fkummer/GoodnightPi/Website/images/IMG_3987.JPG

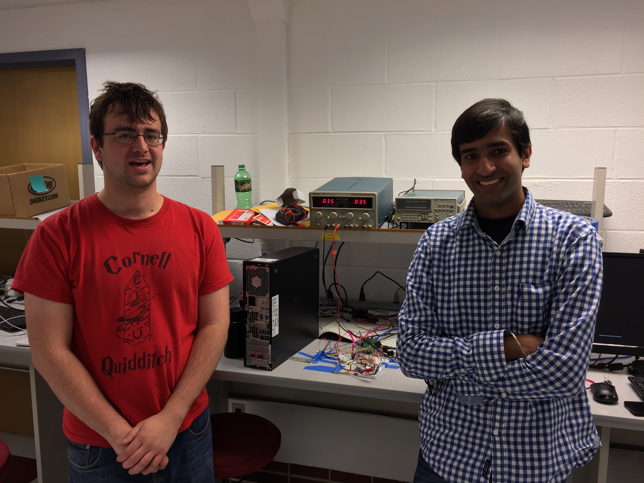
Website/images/IMG_3987.JPG
