fkummer/GoodnightPi/Website/images/IMG_3984.JPG

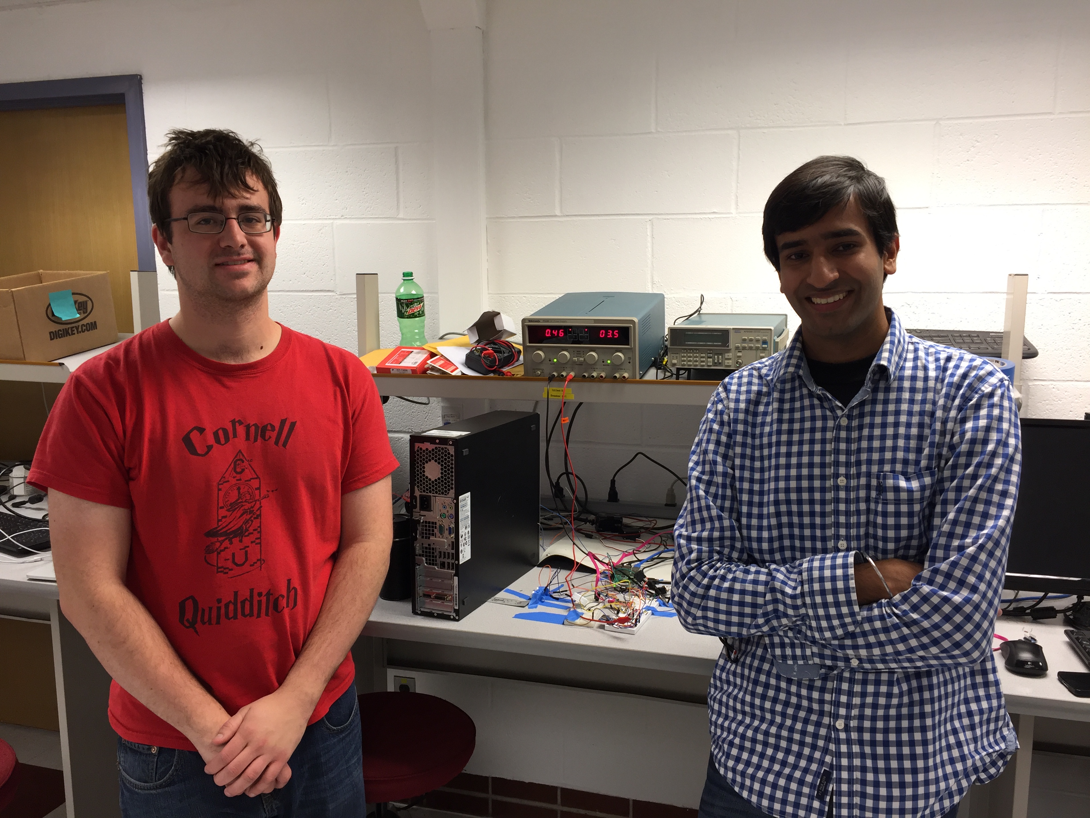
Website/images/IMG_3984.JPG
