fkummer/GoodnightPi/interrupt.jpg

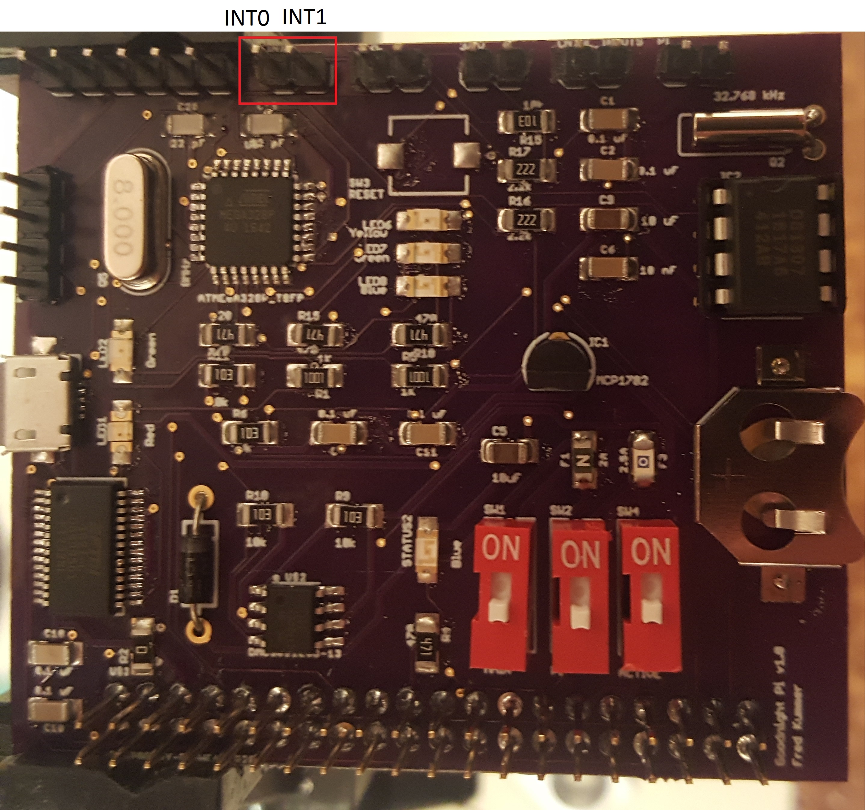
interrupt.jpg
