fkummer/GoodnightPi/LED.jpg

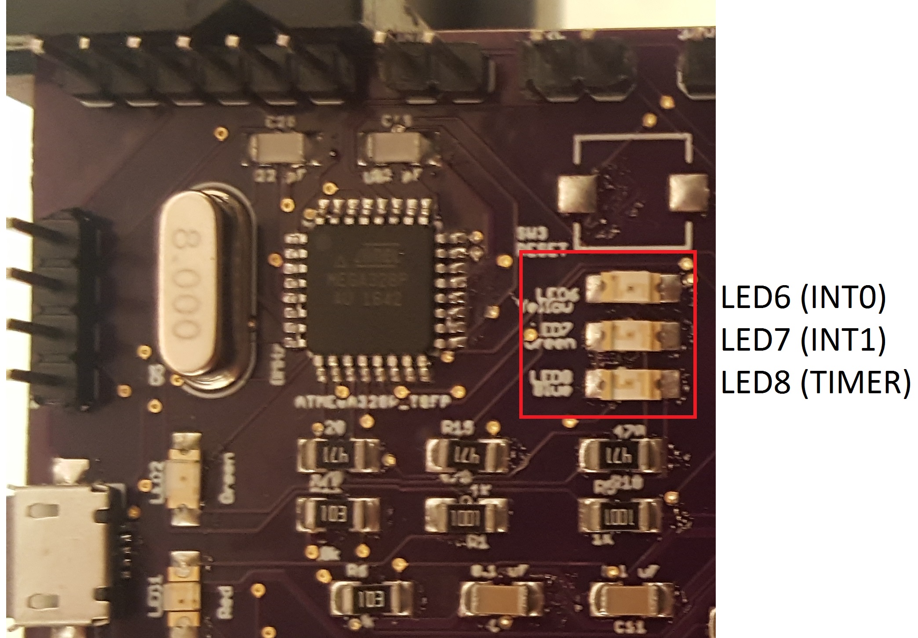
LED.jpg
