fkummer/GoodnightPi/switches.jpg

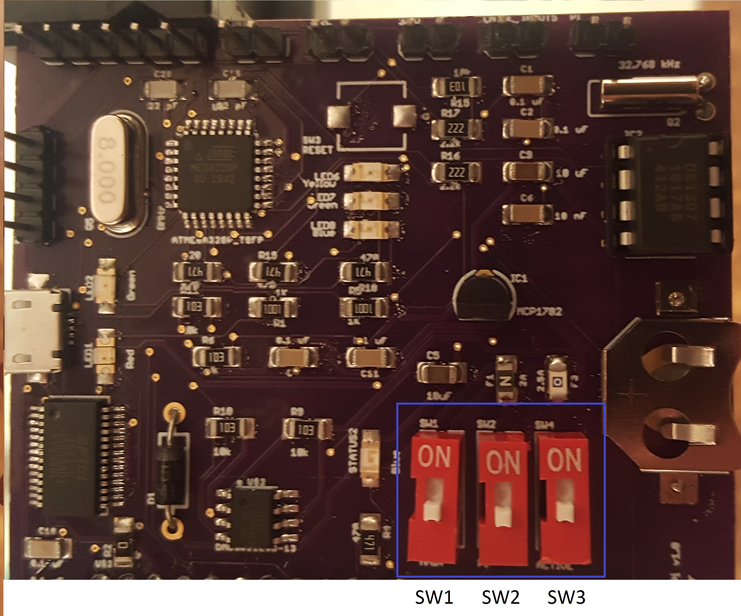
switches.jpg
