fkummer/GoodnightPi/Website/images/at_circ.jpg

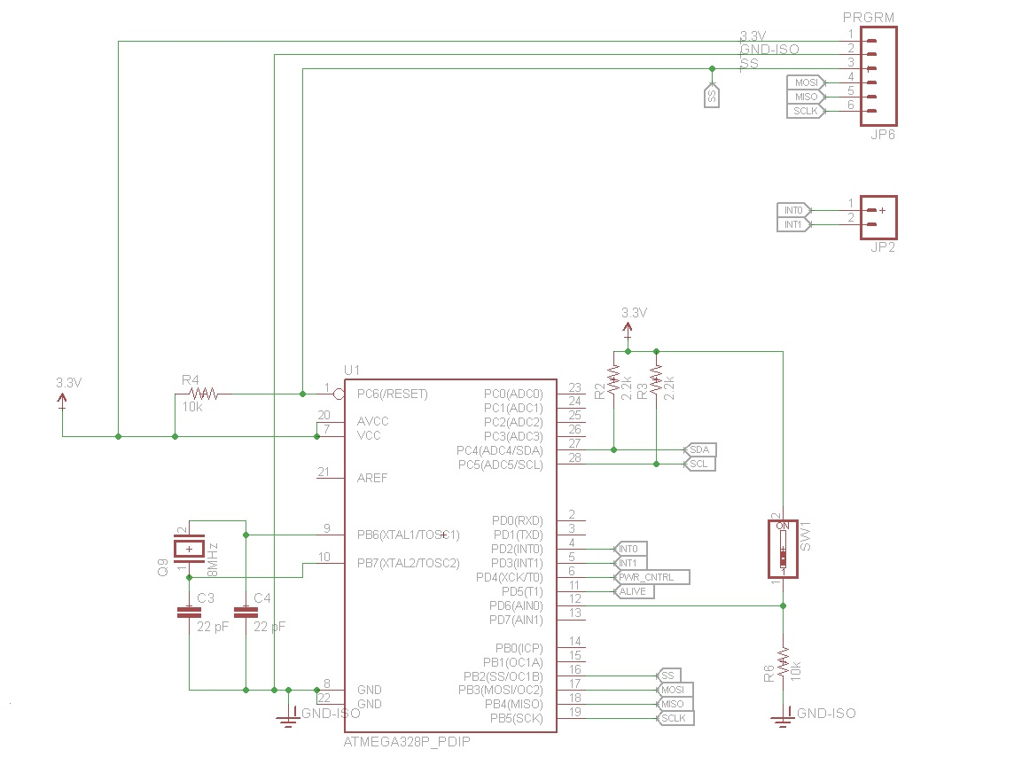
Website/images/at_circ.jpg
