fkummer/GoodnightPi/Website/images/at_spi.jpg

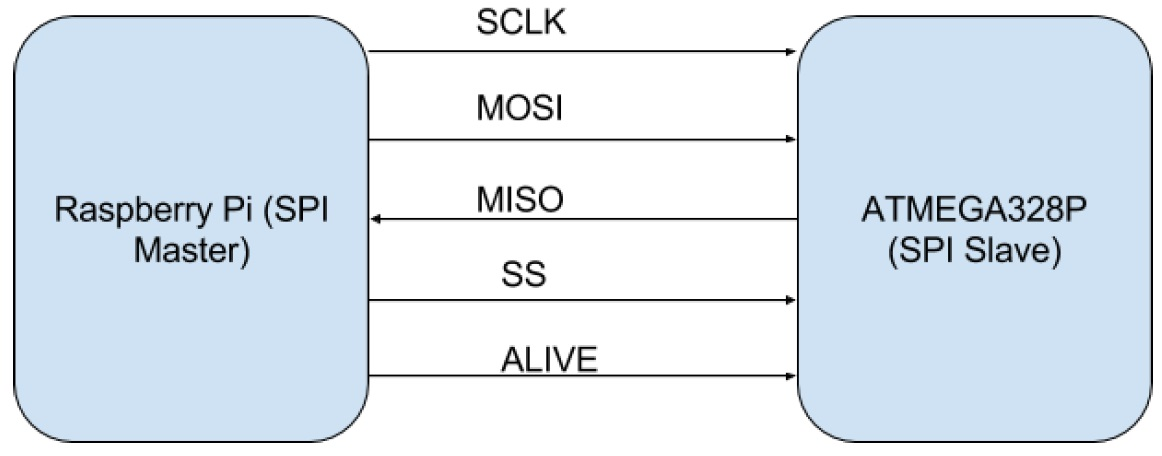
Website/images/at_spi.jpg
