fkummer/GoodnightPi/Website/images/atmega_cycle.jpg

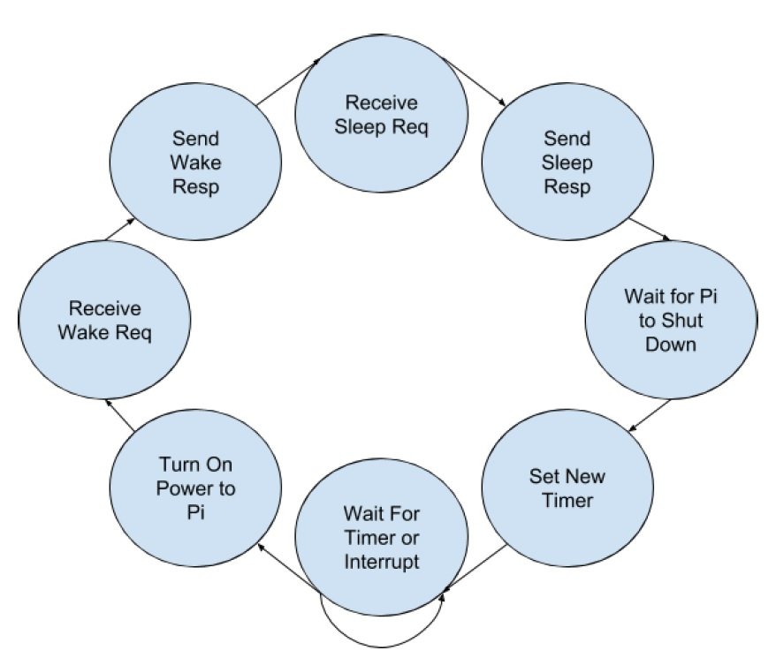
Website/images/atmega_cycle.jpg
