fkummer/GoodnightPi/Website/images/block.jpg

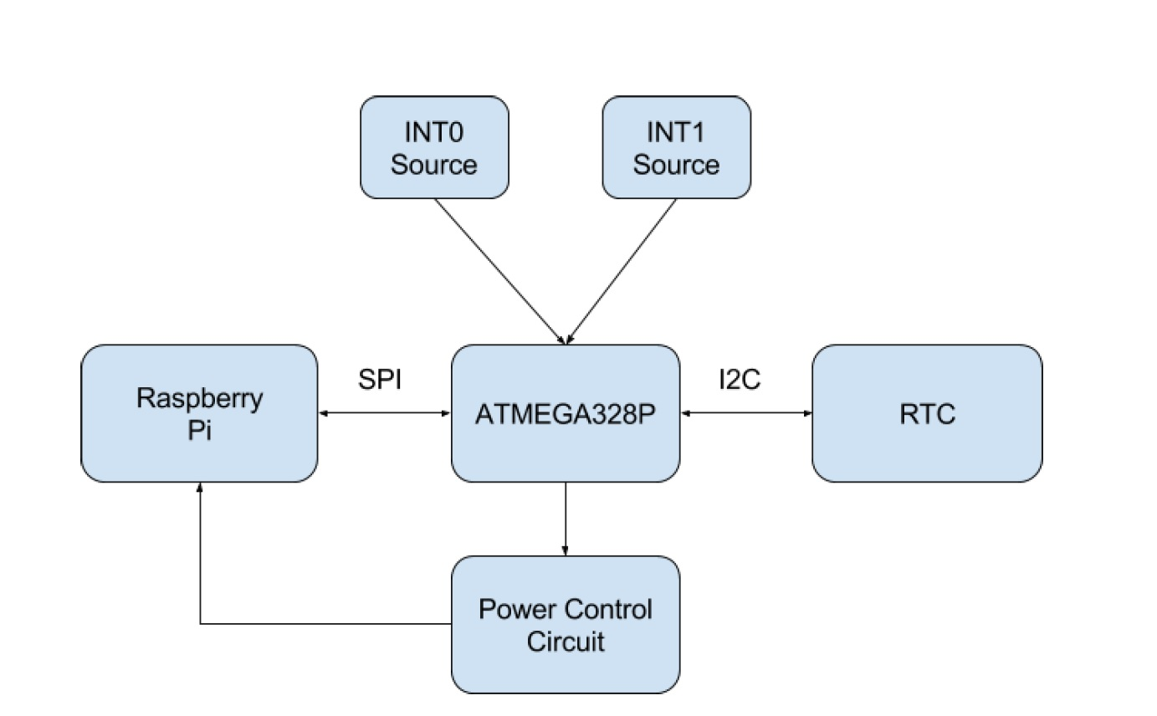
Website/images/block.jpg
