fkummer/GoodnightPi/Website/images/full_schem.jpg

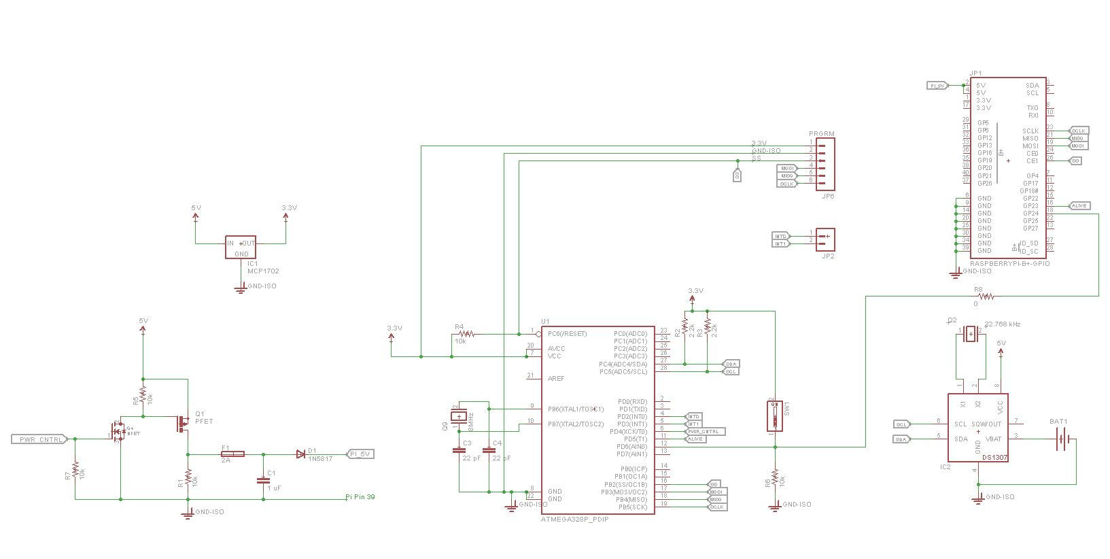
Website/images/full_schem.jpg
