fkummer/GoodnightPi/Website/images/GUI.PNG

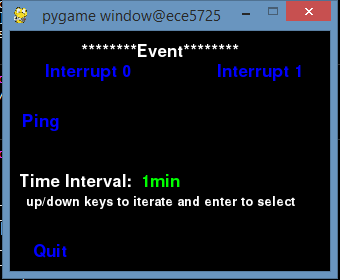
Website/images/GUI.PNG
