fkummer/GoodnightPi/Website/images/IMG_3982.JPG

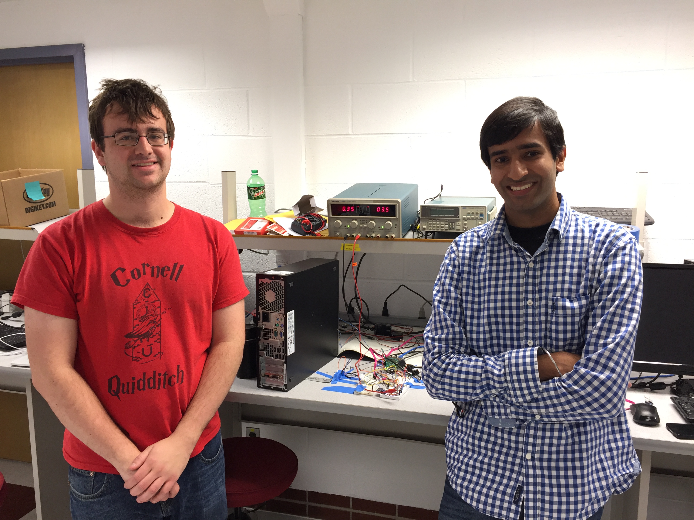
Website/images/IMG_3982.JPG
