fkummer/GoodnightPi/Website/images/IMG_3988.JPG

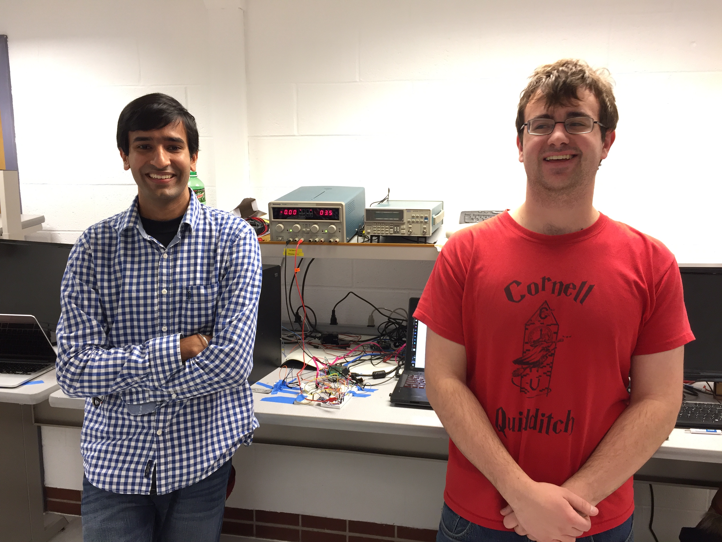
Website/images/IMG_3988.JPG
