fkummer/GoodnightPi/Website/images/pcu.jpg

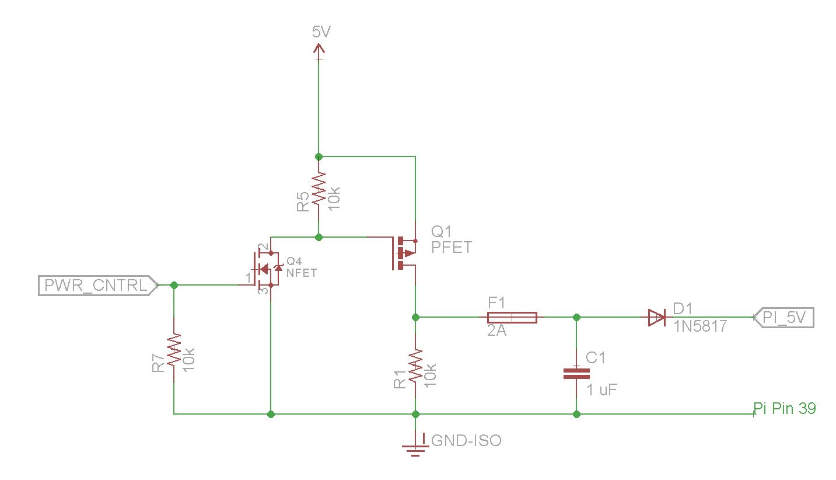
Website/images/pcu.jpg
