fkummer/GoodnightPi/Website/images/pi_cycle.jpg

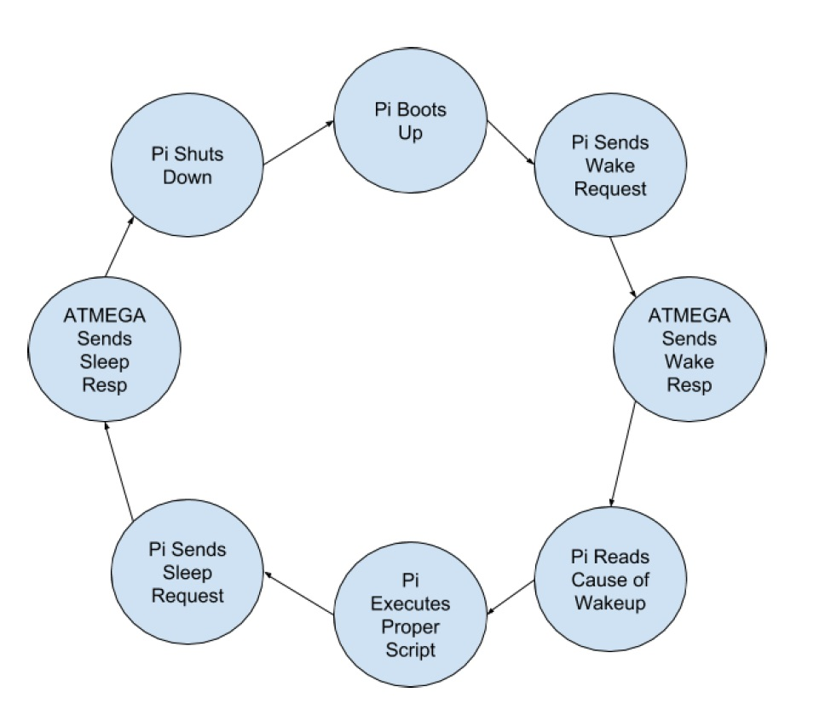
Website/images/pi_cycle.jpg
