fkummer/GoodnightPi/Website/images/rtc.jpg

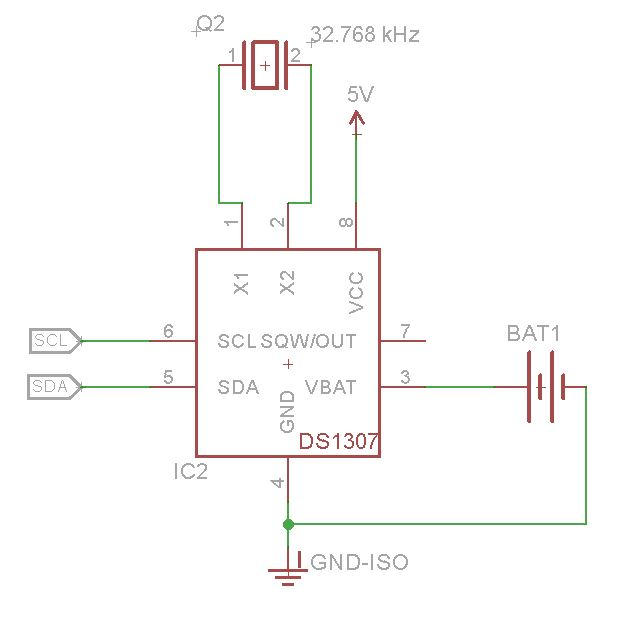
Website/images/rtc.jpg
