fkummer/GoodnightPi/Website/images/team.jpg

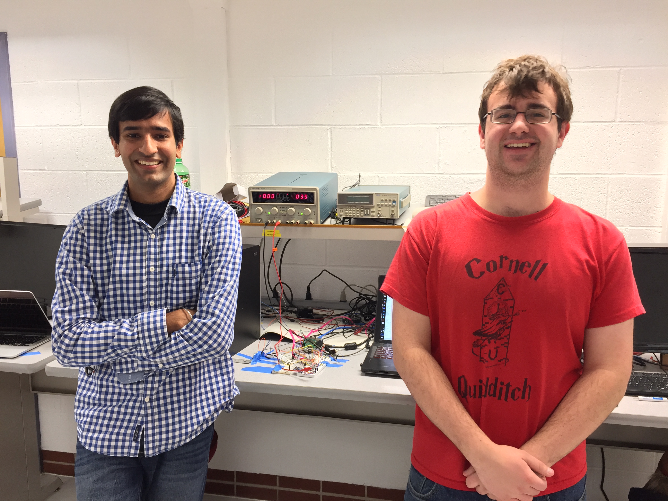
Website/images/team.jpg
