fkummer/GoodnightPi/PCU_R0.brd

## EAGLE design PCU_R0.brd (2017-05-02)

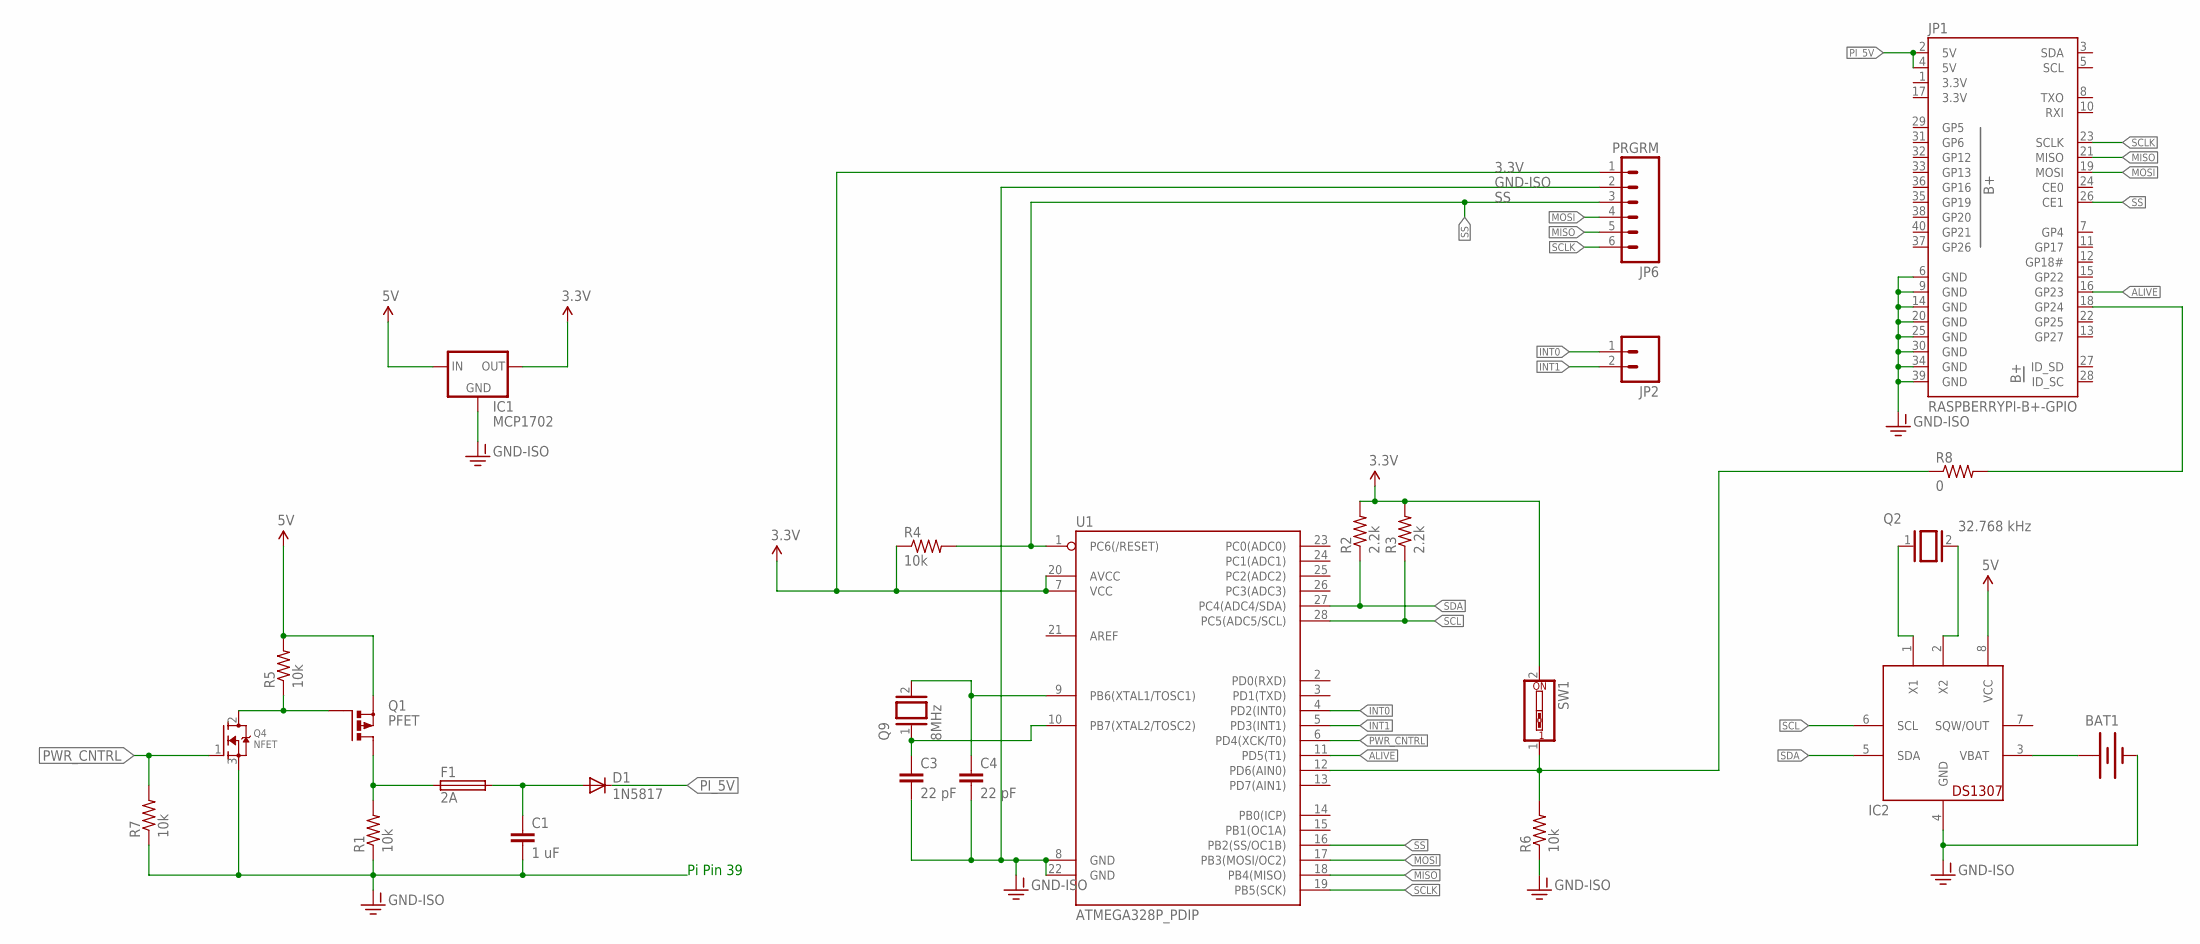
[picture p22: schematic PCU_R0.sch]

Parts:
BAT1: BATTERY12MM; BATTCON_12MM
C1: 1 uF; C2.5-3
C3, C4: 22 pF; C2.5-3
D1: 1N5817; DO41-10
F1: 2A; PICOFUSE
IC1: MCP1702; TO92
IC2: DS1307; DIL08
JP1: RASPBERRYPI-B+-GPIO; 2X20-SHROUDED
JP2: M02PTH; 1X02
JP6: PRGRM; 1X06
Q1: PFET; TO220BV
Q2: 32.768 kHz; QS
Q4: NFET; TO220V
Q9: 8MHz; QS
R1, R4, R5, R6, R7: 10k; 1206
R2, R3: 2.2k; 1206
R8: 0; 1206
SW1: SW_DIP-1; EDG-01
U1: ATMEGA328P_PDIP; DIL28-3

Connections:
3.3V: IC1.3 (OUT), JP1.1 (3.3V), JP1.17 (3.3V), JP6.1, R2.2, R3.2, R4.1, SW1.2, U1.7 (VCC), U1.20 (AVCC)
5V: IC1.2 (IN), IC2.8 (VCC), Q1.S, R5.2
ALIVE: JP1.16 (GP23), U1.11 (PD5(T1))
GND-ISO: BAT1.GND (-), C1.2, C3.2, C4.2, IC1.1 (GND), IC2.4 (GND), JP1.6 (GND), JP1.9 (GND), JP1.14 (GND), JP1.20 (GND), JP1.25 (GND), JP1.30 (GND), JP1.34 (GND), JP1.39 (GND), JP6.2, Q4.3 (S), R1.1, R6.1, R7.1, U1.8 (GND), U1.22 (GND)
INT0: JP2.1, U1.4 (PD2(INT0))
INT1: JP2.2, U1.5 (PD3(INT1))
MISO: JP1.21 (MISO), JP6.5, U1.18 (PB4(MISO))
MOSI: JP1.19 (MOSI), JP6.4, U1.17 (PB3(MOSI/OC2))
unnamed: F1.1, Q1.D, R1.2
unnamed: C1.1, D1.A, F1.2
unnamed: IC2.1 (X1), Q2.1
unnamed: IC2.2 (X2), Q2.2
unnamed: BAT1.PWR@1 (+), IC2.3 (VBAT)
unnamed: Q1.G, Q4.2 (D), R5.1
unnamed: JP1.18 (GP24), R8.2
unnamed: R6.2, R8.1, SW1.1, U1.12 (PD6(AIN0))
unnamed: C3.1, Q9.1, U1.10 (PB7(XTAL2/TOSC2))
unnamed: C4.1, Q9.2, U1.9 (PB6(XTAL1/TOSC1))
PI_5V: D1.C, JP1.2 (5V), JP1.4 (5V)
PWR_CNTRL: Q4.1 (G), R7.2, U1.6 (PD4(XCK/T0))
SCL: IC2.6 (SCL), R3.1, U1.28 (PC5(ADC5/SCL))
SCLK: JP1.23 (SCLK), JP6.6, U1.19 (PB5(SCK))
SDA: IC2.5 (SDA), R2.1, U1.27 (PC4(ADC4/SDA))
SS: JP1.26 (CE1), JP6.3, R4.2, U1.1 (PC6(/RESET)), U1.16 (PB2(SS/OC1B))

Notes on the sheet:
Pi Pin 39

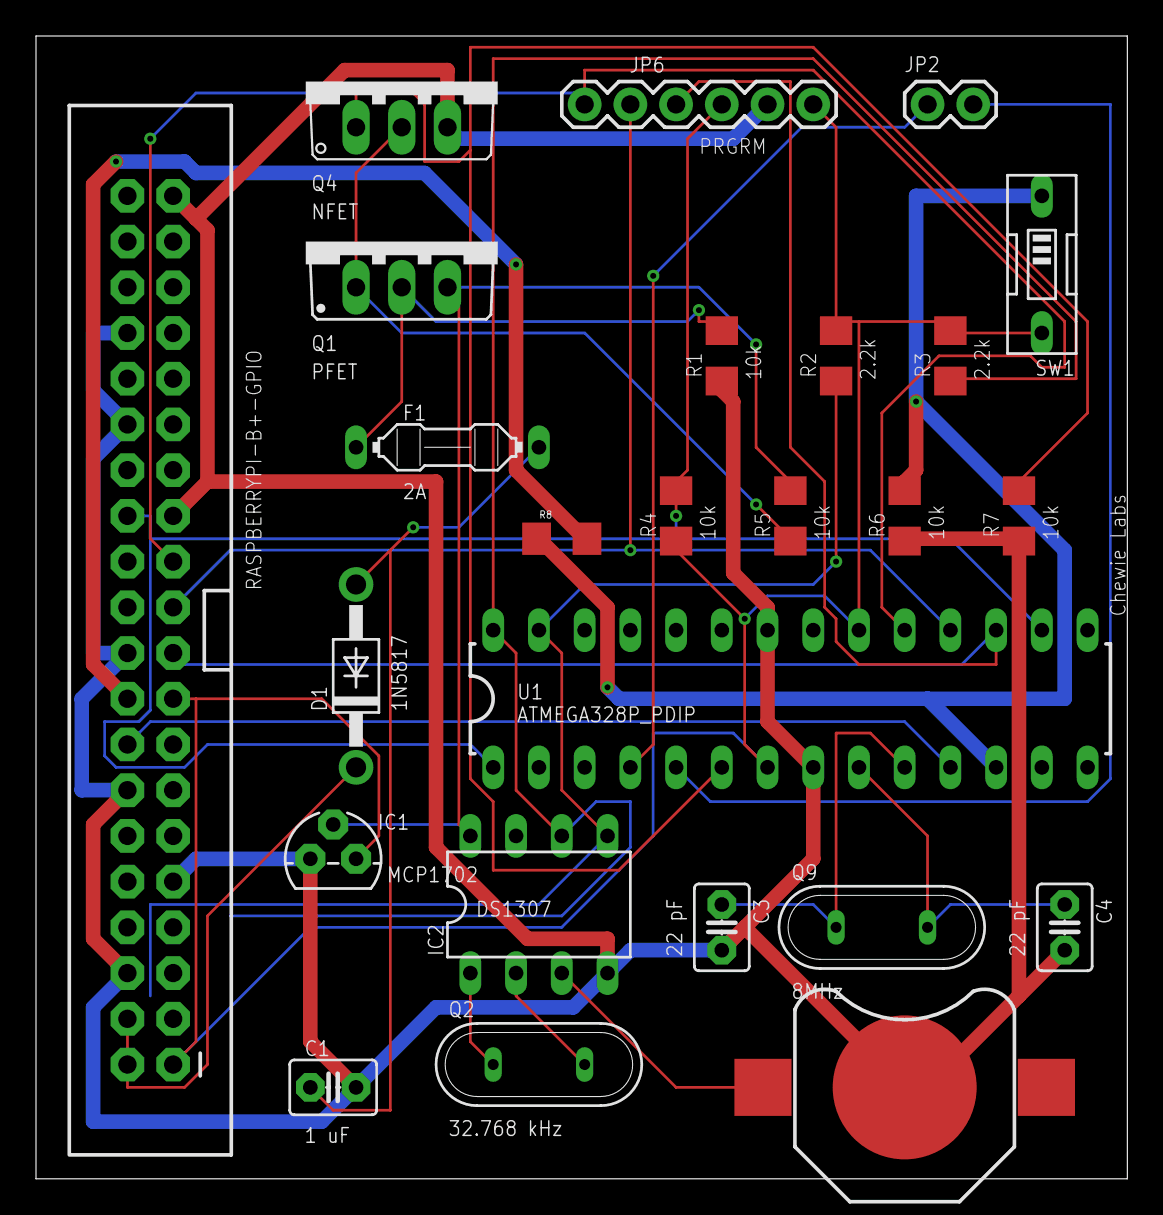
[picture p23: board PCU_R0.brd from above]

Board: 2 copper layers, 60.6 x 63.5 mm, 25 parts (0 on the bottom side), 24 nets.
