fkummer/GoodnightPi/PCU_R1.brd

## EAGLE design PCU_R1.brd (2017-05-02)

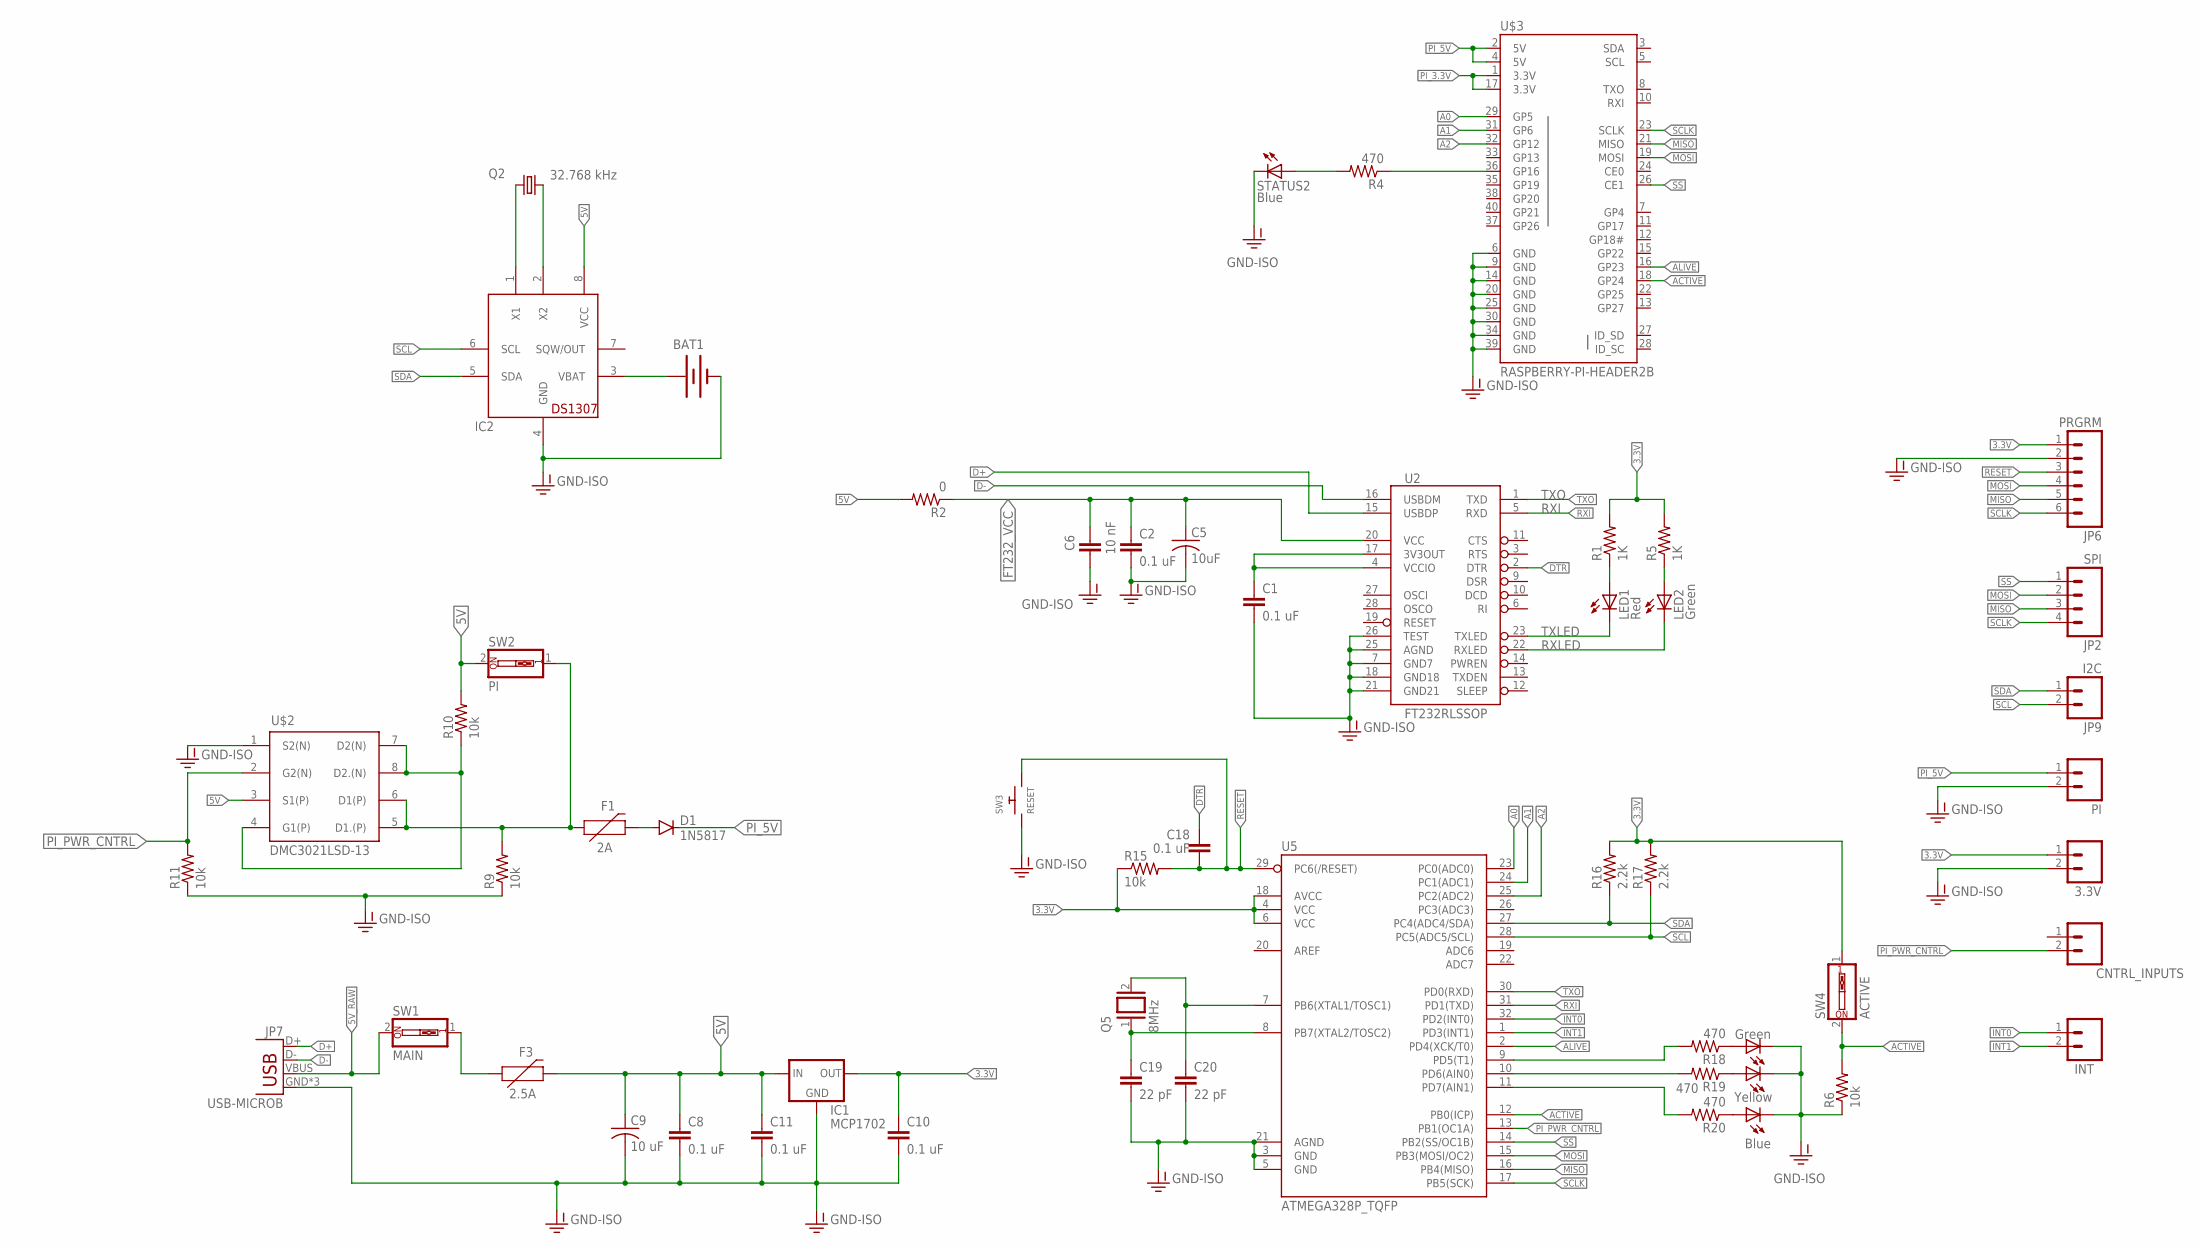
[picture p24: schematic PCU_R1.sch]

Parts:
3.3V: M02PTH; 1X02
BAT1: BATTERY12MM; BATTCON_12MM
C1, C2, C8, C10, C11, C18: 0.1 uF; 1206
C5: 10uF; C1206
C6: 10 nF; 1206
C9: 10 uF; C1206
C19, C20: 22 pF; 1206
CNTRL_INPUTS: M02PTH; 1X02
D1: 1N5817; DIODE-1N4001
F1: 2A; 1206
F3: 2.5A; 1206
IC1: MCP1702; TO92
IC2: DS1307; DIL08
INT: M02PTH; 1X02
JP2: SPI; 1X04
JP6: PRGRM; 1X06
JP7: USB-MICROB
JP9: I2C; 1X02
LED1: Red; CHIPLED_1206
LED2, LED6: Green; CHIPLED_1206
LED7: Yellow; CHIPLED_1206
LED8: Blue; CHIPLED_1206
PI: M02PTH; 1X02
Q2: 32.768 kHz; TC38H
Q5: 8MHz; QS
R1, R5: 1K; 1206
R2: 0; 1206
R4, R18, R19, R20: 470; 1206
R6, R15: 10k; 1206
R9, R10, R11: 10k; R1206
R16, R17: 2.2k; 1206
STATUS2: Blue; CHIPLED_1206
SW1: MAIN; EDG-01
SW2: PI; EDG-01
SW3: RESET; PUSHBUTTON_SMD_SJ
SW4: ACTIVE; EDG-01
U2: FT232RLSSOP; SSOP28DB
U5: ATMEGA328P_TQFP; TQFP32-08
U$2: DMC3021LSD-13; SOIC-8
U$3: RASPBERRY-PI-HEADER2B; 2X20-NOSILK

Connections:
3.3V: 3.3V.1, C10.1, IC1.3 (OUT), JP6.1, R1.2, R5.2, R15.1, R16.2, R17.2, SW4.1, U5.4 (VCC), U5.6 (VCC), U5.18 (AVCC)
5V: C8.1, C9.1, C11.1, F3.2, IC1.2 (IN), IC2.8 (VCC), R2.2, R10.2, SW2.2, U$2.3 (S1(P))
5V_RAW: JP7.VBUS, SW1.2
5V_SWITCH: F3.1, SW1.1
A0: U5.23 (PC0(ADC0)), U$3.29 (GP5)
A1: U5.24 (PC1(ADC1)), U$3.31 (GP6)
A2: U5.25 (PC2(ADC2)), U$3.32 (GP12)
ACTIVE: R6.2, SW4.2, U5.12 (PB0(ICP)), U$3.18 (GP24)
ALIVE: U5.2 (PD4(XCK/T0)), U$3.16 (GP23)
D+: JP7.D+, U2.15 (USBDP)
D-: JP7.D-, U2.16 (USBDM)
DTR: C18.1, U2.2 (DTR)
FT232_VCC: C2.1, C5.1, C6.2, R2.1, U2.20 (VCC)
FUSE_DIODE_PI: D1.A, F1.2
GND-ISO: 3.3V.2, BAT1.GND (-), C1.2, C2.2, C5.2, C6.1, C8.2, C9.2, C10.2, C11.2, C19.2, C20.2, IC1.1 (GND), IC2.4 (GND), JP6.2, JP7.GND, JP7.MT1 (GND), JP7.MT2 (GND), LED6.C, LED7.C, LED8.C, PI.2, R6.1, R9.1, R11.1, STATUS2.C, SW3.P$1, U2.7 (GND7), U2.18 (GND18), U2.21 (GND21), U2.25 (AGND), U2.26 (TEST), U5.3 (GND), U5.5 (GND), U5.21 (AGND), U$2.1 (S2(N)), U$3.6 (GND), U$3.9 (GND), U$3.14 (GND), U$3.20 (GND), U$3.25 (GND), U$3.30 (GND), U$3.34 (GND), U$3.39 (GND)
GP16: R4.1, U$3.36 (GP16)
INT0: INT.1, U5.32 (PD2(INT0))
INT1: INT.2, U5.1 (PD3(INT1))
MISO: JP2.3, JP6.5, U5.16 (PB4(MISO)), U$3.21 (MISO)
MOSI: JP2.2, JP6.4, U5.15 (PB3(MOSI/OC2)), U$3.19 (MOSI)
unnamed: LED1.A, R1.1
unnamed: LED2.A, R5.1
unnamed: IC2.1 (X1), Q2.1
unnamed: IC2.2 (X2), Q2.2
unnamed: BAT1.PWR@1 (+), IC2.3 (VBAT)
unnamed: R4.2, STATUS2.A
unnamed: LED6.A, R18.1
unnamed: LED7.A, R19.1
unnamed: LED8.A, R20.1
PD5: R18.2, U5.9 (PD5(T1))
PD6: R19.2, U5.10 (PD6(AIN0))
PD7: R20.2, U5.11 (PD7(AIN1))
PI_3.3V: U$3.1 (3.3V), U$3.17 (3.3V)
PI_5V: D1.C, PI.1, U$3.2 (5V), U$3.4 (5V)
PI_N_DRAIN: R10.1, U$2.4 (G1(P)), U$2.7 (D2(N)), U$2.8 (D2.(N))
PI_PWR_CNTRL: CNTRL_INPUTS.2, R11.2, U5.13 (PB1(OC1A)), U$2.2 (G2(N))
PI_P_DRAIN: F1.1, R9.2, SW2.1, U$2.5 (D1.(P)), U$2.6 (D1(P))
RESET: C18.2, JP6.3, R15.2, SW3.P$2, U5.29 (PC6(/RESET))
RXI: U2.5 (RXD), U5.31 (PD1(TXD))
RXLED: LED2.C, U2.22 (RXLED)
SCL: IC2.6 (SCL), JP9.2, R17.1, U5.28 (PC5(ADC5/SCL))
SCLK: JP2.4, JP6.6, U5.17 (PB5(SCK)), U$3.23 (SCLK)
SDA: IC2.5 (SDA), JP9.1, R16.1, U5.27 (PC4(ADC4/SDA))
SS: JP2.1, U5.14 (PB2(SS/OC1B)), U$3.26 (CE1)
TXLED: LED1.C, U2.23 (TXLED)
TXO: U2.1 (TXD), U5.30 (PD0(RXD))
VCCIO: C1.1, U2.4 (VCCIO), U2.17 (3V3OUT)
XTAL1: C20.1, Q5.2, U5.7 (PB6(XTAL1/TOSC1))
XTAL2: C19.1, Q5.1, U5.8 (PB7(XTAL2/TOSC2))

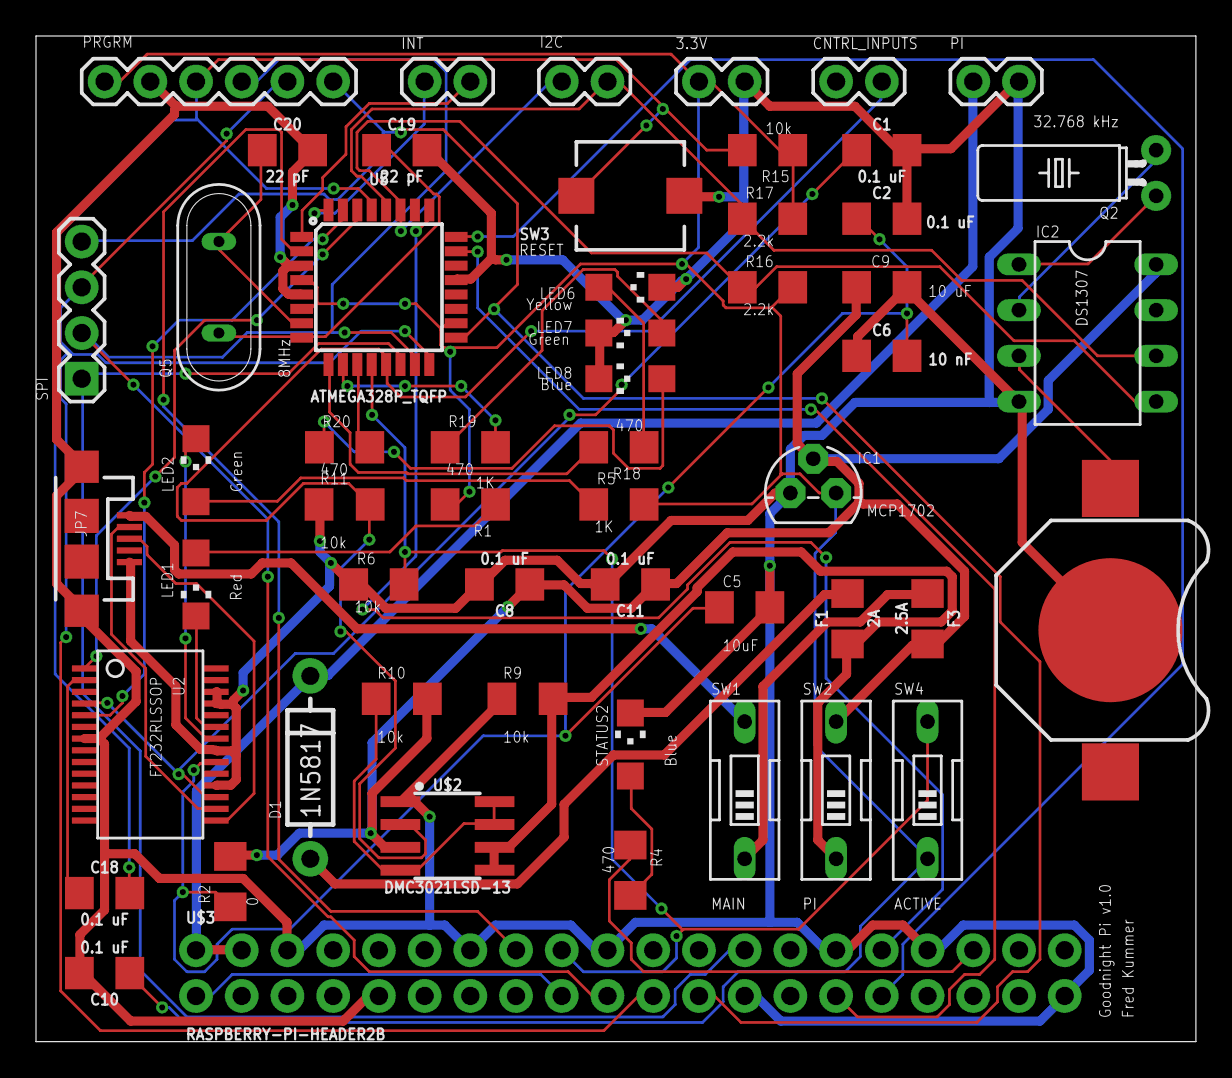
[picture p25: board PCU_R1.brd from above]

Board: 2 copper layers, 64.4 x 55.9 mm, 55 parts (0 on the bottom side), 49 nets.
