fkummer/GoodnightPi/ATMEGA_CODE/Full_Final/Full_Final.ino

#include "Wire.h"
#include <RTClib.h>
#include <SPI.h>
#include <EEPROM.h>

#define NOT_AN_INTERRUPT -1

//Variables for I2C
RTC_DS1307 rtc;
long wakeTime;
char timeSet = 0;
char ledState = 0;

//Variables for SPI
volatile unsigned char SPI_buff[100];
volatile byte cnt = 0;
volatile byte pos = 0;
volatile byte resp = 0;
volatile byte incoming = 0;
volatile byte outgoing = 0;
unsigned char resp_buff[11];
volatile unsigned char recv_packet[11];
volatile byte resp_ind = 0;
volatile byte supress_int = 0;

//Is Pi alive
boolean alive = 1;

//Do we want to turn off the power when we get the chance?
boolean gotoSleep = 0;

//timeInterval for our next wakeup.
long timeInterval = 0;

//Is int0 enabled
byte int0 = 0;

//Is int1 enable
byte int1 = 0;

//timer wants us to get up
byte timer_woke = 0;

//interrupt 0 wants us to get up
volatile byte int0_woke = 0;

//interrupt 1 wants us to get up
volatile byte int1_woke = 0;

//Are we waiting to get up
byte wait_for_wake = 0;

#define LED   7
#define PACKET_LEN 11
#define ALIVE 4
#define PWR_CNTRL 9
#define INT0 2
#define INT1 3
#define GREEN 6
#define YELLOW 5

// SPI interrupt routine
//Capture what is coming in. 
ISR (SPI_STC_vect)
{
  if(pos > 99){
    pos = 0;
  }
  
  //Serial.println(SPDR);
  
  //If we are receiving a packet
  if(incoming){
    cnt++;
    //Serial.println(SPDR);
    SPI_buff[pos] = SPDR;
    pos++;
    
    if(cnt >= PACKET_LEN){
      Serial.println("itsa me");
      incoming = 0;
      outgoing = 1;
    }
  }else{//Look for start byte
    if(SPDR == 0xFE){
      //Serial.println("start");
      incoming = 1;
      
      outgoing = 0;
      cnt = 0;
    }
  }
  
  
  //The master is asking us for a response and we expect to return one.
  
  //HERES THE PROBLEM: We are overwriting the SPDR so we can't get this 0xFF? Or is this pi sending us Y? Check on scope.
  if(SPDR == 0xFF){
    //Serial.println("AH");
    SPDR = resp_buff[resp_ind];
    resp_ind++;
  }
  
}// end of interrupt service routine (ISR) SPI_STC_vect

byte getOpCode(byte receivedOpCode){
  switch (receivedOpCode){
    case 0x00://Respond to WAKE_REQ with WAKE_RESP
      return 0x01;
      break;
    case 0x02:
      return 0x03;
      break;
    case 0x04:
      return 0x05;
      break;
    case 0x06:
      return 0x07;
      break;
    default: 
      return 0xFF;
      break;
  }
}  

void fillPayload(byte opCode, unsigned char * buff){
  switch (opCode){
    case 0x01: //WAKE_RESP
      //4 bytes for the time interval that woke it
      if(timer_woke == 1){
        Serial.println("Timer woke");
        buff[1] = timeInterval & 0x000000FF;
        buff[2] = timeInterval & 0x0000FF00;
        buff[3] = timeInterval & 0x00FF0000;
        buff[4] = timeInterval & 0xFF000000;
      }else{
        buff[1] = 0;
        buff[2] = 0;
        buff[3] = 0;
        buff[4] = 0;
      }
      
      //1 byte for if interrupt 0 woke it or not
      if(int0_woke == 1){
        Serial.println("Interrupt 0 woke");
        buff[5] = 1;
      }else{
        buff[5] = 0;
      }
      
      //1 byte for if interrupt 1 woke it or not
      if(int1_woke == 1){
        Serial.println("Interrupt 1 woke");
        buff[6] = 1;
      }else{
        buff[6] = 0;
      }
      
      //4 empty bytes
      buff[7] = 0;
      buff[8] = 0;
      buff[9] = 0;
      buff[10] = 0x00;
      
      //Clear what woke us
      timer_woke = 0;
      int0_woke = 0;
      int1_woke = 0;
      break;
      
    case 0x03: //SLEEP_RESP
      fillEmpty(buff);
      break;
      
    case 0x05: //CONFIG_RESP
      fillEmpty(buff);
      break; 
    
    case 0x07: //PING_RESP
      fillEmpty(buff);
      break;
    
    default:
      fillEmpty(buff);
      break;
  }
 
} 

//Set things as needed.
void processPacket(volatile unsigned char * buff){
  unsigned char opCode = buff[0];
  Serial.println("process");
  Serial.println(opCode);
  switch(opCode){
    case 0x00://WAKE_REQ
      //We dont need to do anything!
      break;
      
    case 0x02://SLEEP_REQ
      //Time to sleep
      Serial.println("Im Sleepy");
      
      //Only sleep if we're configured to do something!
      if(timeInterval != 0x00000000 || int0 == 1 || int1 == 1){  
        Serial.println("I think I'll sleep");
        gotoSleep = 1;
      }
      break;
      
    case 0x04:
      int i;
      //Assemble the time interval!
      //Fetchez la vache!
      long tempInterval;
      tempInterval = 0x00000000;
      for(i = 4; i > 0; i--){
        tempInterval = tempInterval | buff[i];
        
        if(i > 1){
          tempInterval = tempInterval << 8;
        }
      }
      
      //This packet is not attempting to configure the timer
      if(tempInterval == 0x00000000){
        //Don't change the timeInterval
      }else{
        //Set interval
        timeInterval = tempInterval;

        //Save interval
        for(i = 4; i > 0; i--){
          EEPROM.write(1+i, buff[i]);
        }
      }
      
      Serial.println("Configured");
      Serial.println(timeInterval);
      
      //into enable/disable
      if(buff[5] == 1){
        Serial.println("\n\ntoggle int0");
        Serial.print("INT0:");
        int0 ^= 1;
        EEPROM.write(0, int0);
        Serial.println(int0);
        Serial.println("\n\n");
        
      }
      
      //int1 enable/disable
      if(buff[7] == 1){
        Serial.println("toggle int1");
        int1 ^= 1;
        EEPROM.write(1, int1);
      }
      
      break;
      
    case 0x06:
      //We dont need to do anything!
      break;
      
    default:
      break;
  }
  
}

void processInterrupts(){

  
}

//Specifically for populating empty payloads, since its so common.
void fillEmpty(unsigned char * buff){
  byte buff_ind;
  for(buff_ind = 1; buff_ind < PACKET_LEN; buff_ind++){
    buff[buff_ind] = 'a';
  }
}

//Pass in the number of seconds until next wake up, calculate 
//the appropriate unix time for to wake up. Set the timer flag
void setWakeupTime(long seconds){
  Serial.println("Set");
  wakeTime = rtc.now().unixtime() + seconds;
  timeSet = 1;
}

char checkWakeup(){
  //Serial.println(timeSet, DEC);
  if(timeSet != 0){
    //Serial.println(rtc.now().unixtime());
    //delay(1000);
    if(rtc.now().unixtime() >= wakeTime){
      //Time to get up!
     timeSet = 0;
     timer_woke = 1;
     Serial.println("hm");
     return 1;  
    }
  }

  return 0;
}

void handleSPI(){
  //Received a full packet, lets print it
  //We should also get our response ready!
  
  if(cnt == PACKET_LEN){  
    //Print out the packet
    byte ind;
    
    if(pos < PACKET_LEN){
      ind = 99-(pos+1);
    }else{
      ind = (pos-PACKET_LEN)%100;
    }
    
    for(int i = 0; i < PACKET_LEN; i++){
      if(ind > 99){
        ind = 0;
      }
      recv_packet[i] = SPI_buff[ind];
      ind++;
    }
    cnt = 0;

    if(outgoing){
      Serial.println("wow");
      processPacket(recv_packet);
      resp_buff[0] = getOpCode(recv_packet[0]);
      fillPayload(resp_buff[0], resp_buff); 
      SPDR = resp_buff[0];
      resp_ind = 1;
      outgoing = 0;
    }
  }
}

void turnOffPower(){
  Serial.println("going down");
  gotoSleep = 0;
  digitalWrite(PWR_CNTRL, LOW);
  return;
}

void int0_handler(){
  //If interrupts are allowed to wake us
  Serial.println("whoa cool");
  if(int0 == 1){
    Serial.println("neat");
    int int0_cnt = 0;
    while(digitalRead(INT0) && (int0_cnt < 500)){
      int0_cnt = int0_cnt + 1;
    }
    
    if(int0_cnt >= 500){
      Serial.println("awesome");
      int0_woke = 1;
      timeSet = 0;
    }
  }else{
    int0_woke = 0;
  }
}

void int1_handler(){
  //If interrupts are allowed to wake us
  Serial.println("super neat");
  if(int1 == 1){
    Serial.println("wooooooowwweee");
    int int1_cnt = 0;
    while(digitalRead(INT1) && (int1_cnt < 500)){
      int1_cnt = int1_cnt + 1;
    }
    
    if(int1_cnt >= 500){
      Serial.println("radical");
      int1_woke = 1;
      timeSet = 0;
    }
  }else{
    int1_woke = 0;
  }
}


//Gradually turn on to avoid sudden draw
void turnOnSlow(){
  int val = 0;

  while(val < 255){
    val += 1;
    analogWrite(PWR_CNTRL, val);
    delay(40);
  }
  
}


//Gradually turn on to avoid sudden draw
void turnOnPower(){
  digitalWrite(PWR_CNTRL, HIGH);
}

void setup() {
  Serial.begin(115200);
  
  
  //SPI setup
  SPI.setClockDivider(SPI_CLOCK_DIV16);
  
  // have to send on master in, *slave out*
  pinMode(MISO, OUTPUT);
  
  // turn on SPI in slave mode
  SPCR |= _BV(SPE);
  
  // turn on interrupts
  SPCR |= _BV(SPIE);
  
  //I2C Setup
  rtc.begin();

  pinMode(LED, OUTPUT);
  pinMode(GREEN, OUTPUT);
  pinMode(YELLOW, OUTPUT);
  pinMode(PWR_CNTRL, OUTPUT);
  pinMode(ALIVE, INPUT);
  pinMode(INT0, INPUT);
  pinMode(INT1, INPUT);
 
//  EEPROM.write(0, 0);
//  EEPROM.write(1, 0);
//  EEPROM.write(2, 0);
//  EEPROM.write(3, 0);
//  EEPROM.write(4, 0);
//  EEPROM.write(5, 0);

  
  int0 = EEPROM.read(0);
  int1 = EEPROM.read(1);

  int i;
  //Assemble the time interval!
  long setupInterval;
  setupInterval = 0x00000000;
  byte timeByte;
  
  for(i = 4; i > 0; i--){
    timeByte = EEPROM.read(1+i);
    setupInterval = setupInterval | timeByte;
    if(i > 1){
      setupInterval = setupInterval << 8;
    }
  }
  timeInterval = setupInterval;
  
  attachInterrupt(digitalPinToInterrupt(INT0), int0_handler, RISING);
  attachInterrupt(digitalPinToInterrupt(INT1), int1_handler, RISING);
 
  digitalWrite(YELLOW, int0);
  digitalWrite(GREEN, int1);
  if(timeInterval > 0){
    digitalWrite(LED, HIGH);
  }else{
    digitalWrite(LED, LOW);
  }
  
  delay(6000);
  
 

  turnOnPower();
}


void loop() {
  alive = digitalRead(ALIVE);

  if(alive){
    digitalWrite(YELLOW, int0);
    digitalWrite(GREEN, int1);
    if(timeInterval > 0){
      digitalWrite(LED, HIGH);
    }else{
      digitalWrite(LED, LOW);
    }
  }else{
    digitalWrite(YELLOW, LOW);
    digitalWrite(GREEN, LOW);
    digitalWrite(LED, LOW);
  }
  
  if(gotoSleep){
    if(!alive){
      Serial.println("Beep");
      delay(5000); //Wait to make sure Pi is shutdown
      //attachInterrupt(digitalPinToInterrupt(INT0), int0_handler, RISING);
      //attachInterrupt(digitalPinToInterrupt(INT1), int1_handler, RISING);
      turnOffPower();
      wait_for_wake = 1;
      if(timeInterval != 0){
        Serial.println("Alarming!");
        setWakeupTime(timeInterval);
      }
    }
  }
  
  if(alive){
   //Receive any incoming packets and send a response
   //Serial.println("Live");
   handleSPI();
  }
  
  //Time to wakeup!
  if((checkWakeup() == 1 || int0_woke || int1_woke) && (wait_for_wake == 1) ){
     Serial.println("BRING!");
     //ledState = ledState ^ 1;
     wait_for_wake = 0;
     //detachInterrupt(digitalPinToInterrupt(INT0));
     //detachInterrupt(digitalPinToInterrupt(INT1));
     //digitalWrite(LED,ledState);
     turnOnPower();
  }else{
  
  }
}
