fkummer/GoodnightPi/(commit log)

2016-11-15 Added Arduino Code
2016-11-16 First SPI tests between Arduinos
2016-11-16 Added SPI with a slave response
2016-11-17 Initial communication between Pi and Arduino using SPI
2016-11-17 rtc blinking led
2016-11-17 Starting to make spi for 11 long packets
2016-11-18 Working on SPI
2016-11-21 spi tested from arduino side, 100ms delay required at Pi side to avoid dropping packets. Adding decision.c which parses the messages received
2016-11-29 More SPI
2016-11-30 Began adding functionality to allow for SPI communication on Pi
2016-11-30 Slave response on arduino end working, as well as circular buffer
2016-12-01 Started integrating RTC and SPI
2016-12-04 Updated to actually control power
2016-12-05 ultrasonic wakeup
2017-03-20 Pi side fixed to use relative paths
    [config.txt]
2017-05-02 added schem
    [PCU_R0.brd, PCU_R0.sch, PCU_R1.brd, PCU_R1.sch, PCU_R2.brd, PCU_R2.sch, PCU_R3.brd, PCU_R3.sch]
