fkummer/GoodnightPi/Website/images/atmega.jpg

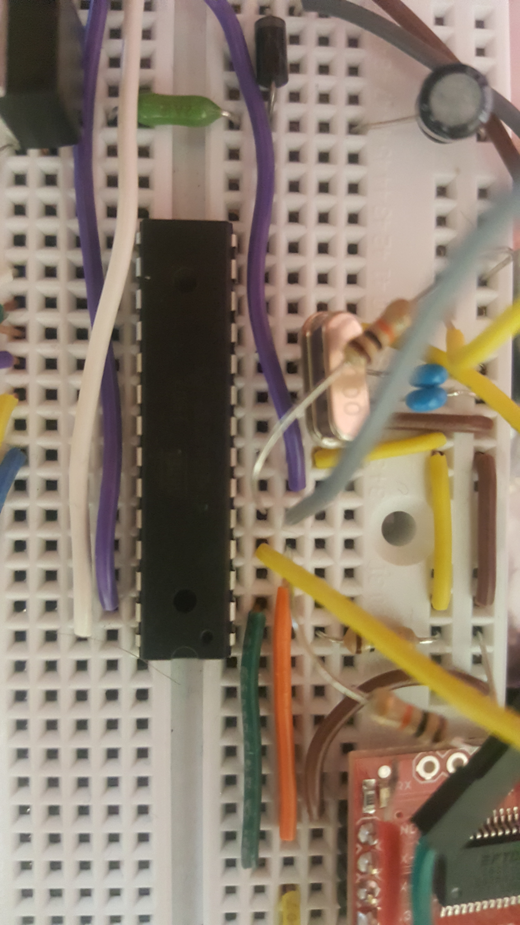
Website/images/atmega.jpg
